ElhasnaouiMedina/Scanner-projet/Diaporama.pdf

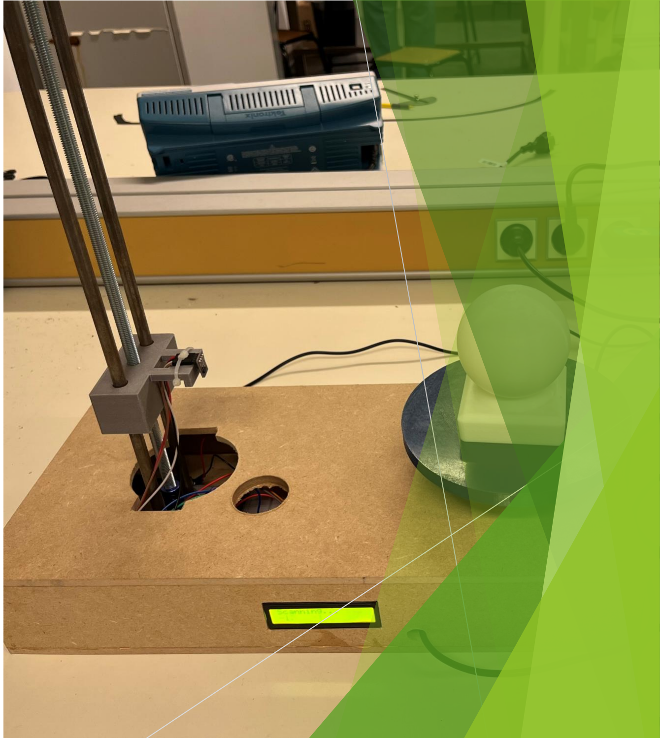
[picture p21: figure]

# Soutenance projet Arduino: Création d’un scanner 3D

MEDINA Anne-Marie

EL HASNAOUI Wiam

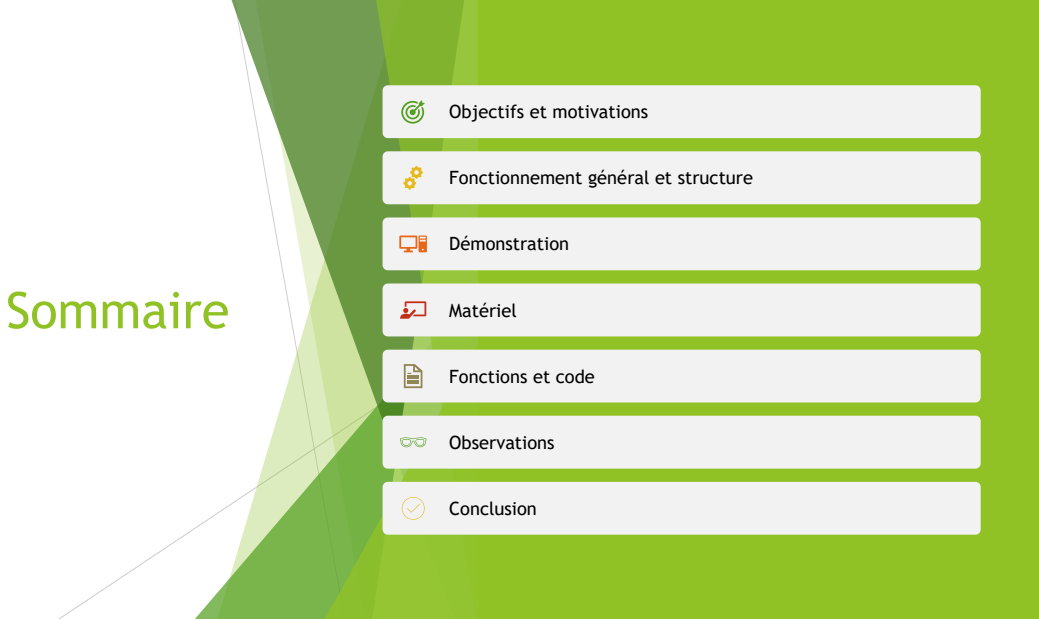
[picture p22: page 2]
Sommaire; Démonstration; Matériel; Observations; Conclusion

Objectifs et motivations

Fonctionnement général et structure

Fonctions et code

# Objectifs et motivations

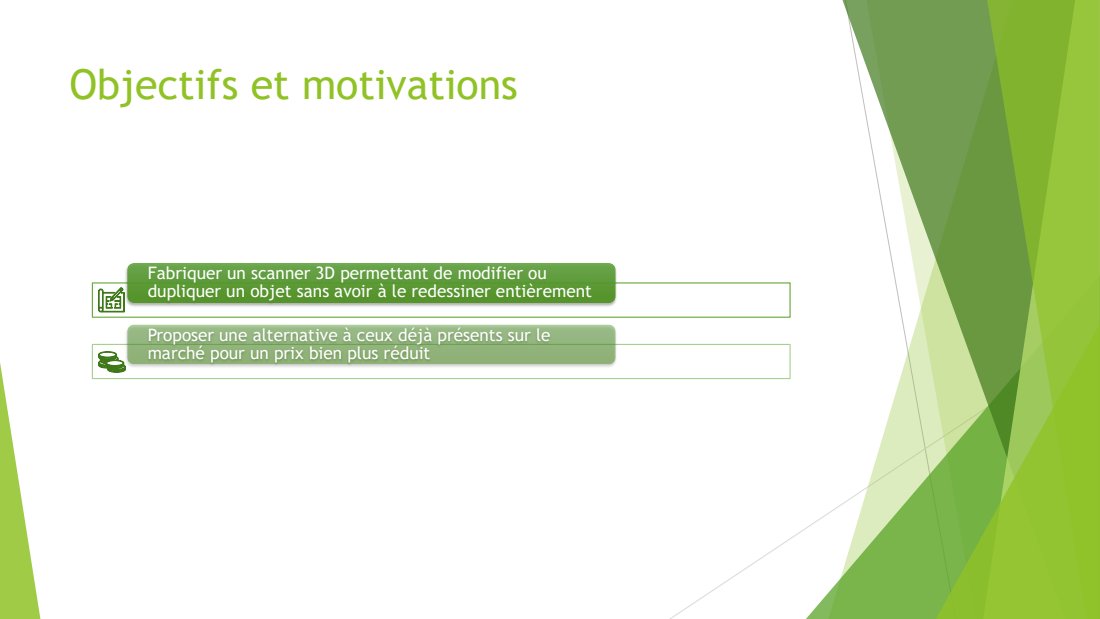
[picture p23: page 3]

Fabriquer un scanner 3D permettant de modifier ou
dupliquer un objet sans avoir à le redessiner entièrement

Proposer une alternative à ceux déjà présents sur le
marché pour un prix bien plus réduit

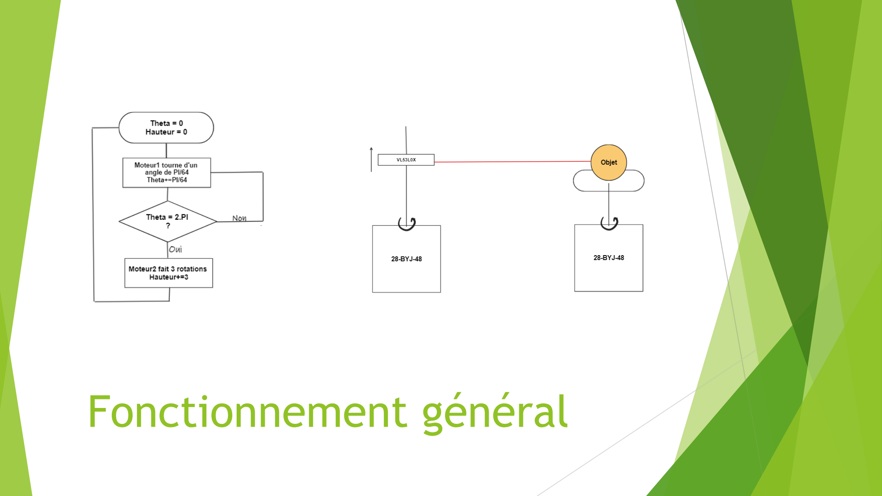
[picture p24: page 4]

# Fonctionnement général

# Structure

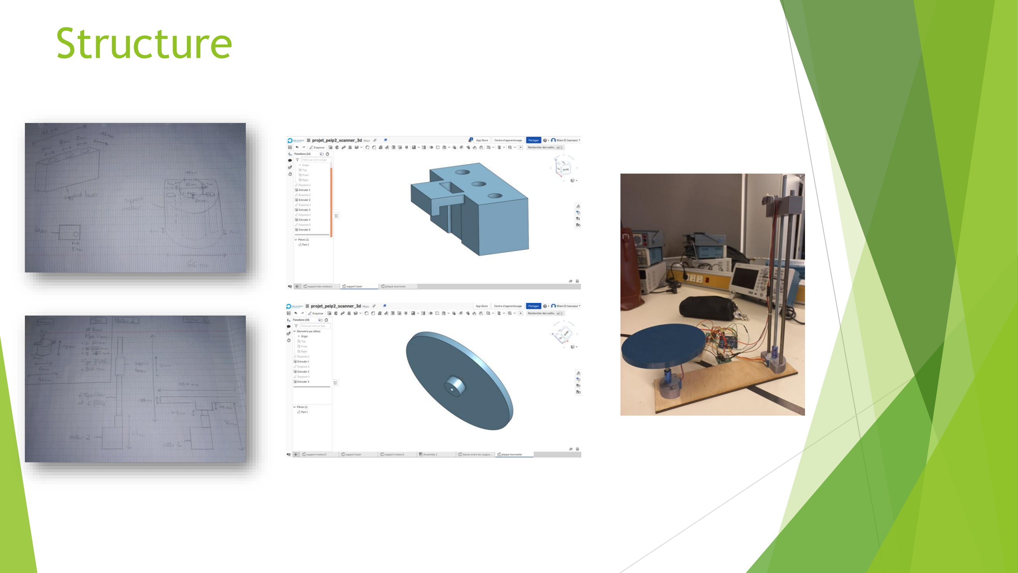
[picture p25: page 5]

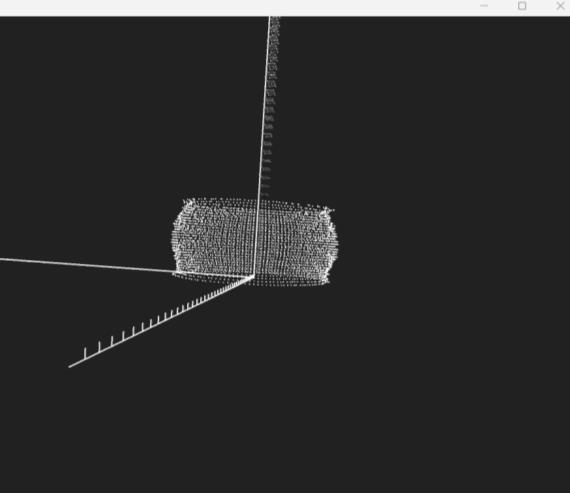
[picture p26: figure]
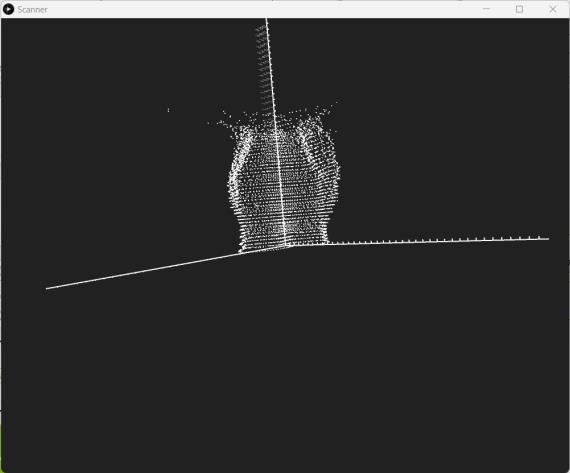
[picture p27: figure]
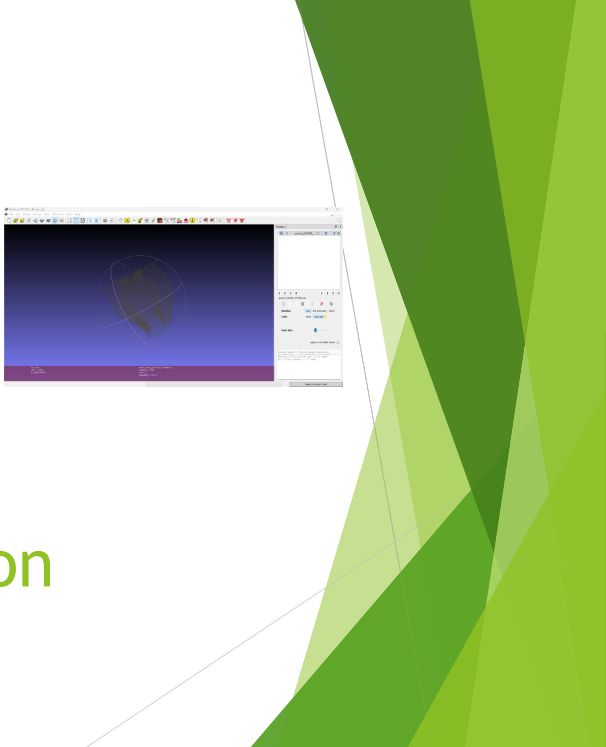
[picture p28: figure]

# Démonstration

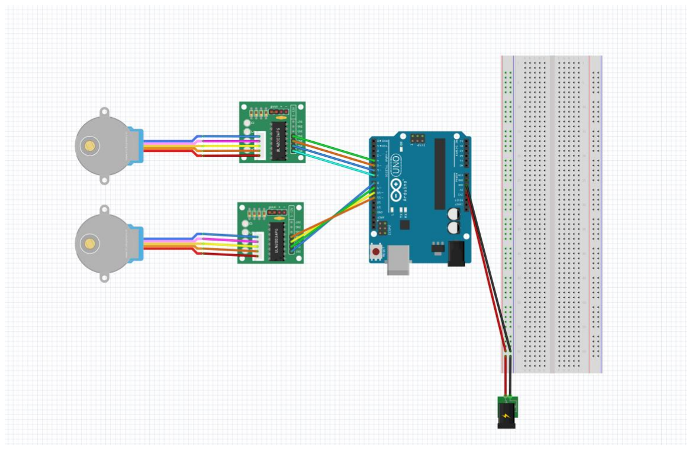
[picture p29: figure]

# Le moteur 28-BYJ-48

- Accompagné du
module UNL2003A
- Alimentée sous 5V

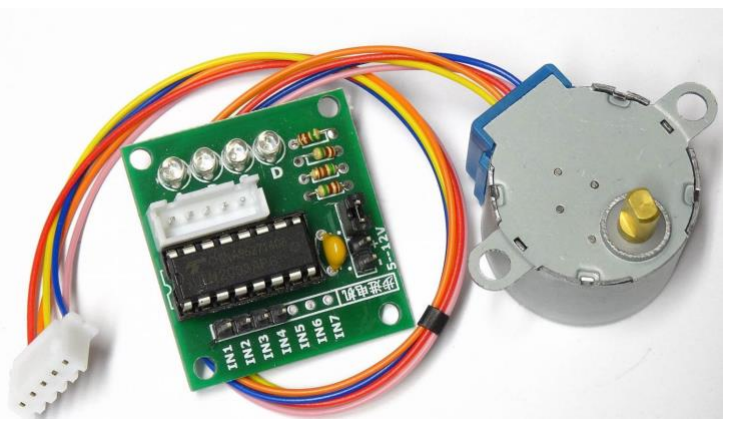
[picture p30: figure]

# Le capteur de distance VL53L0X

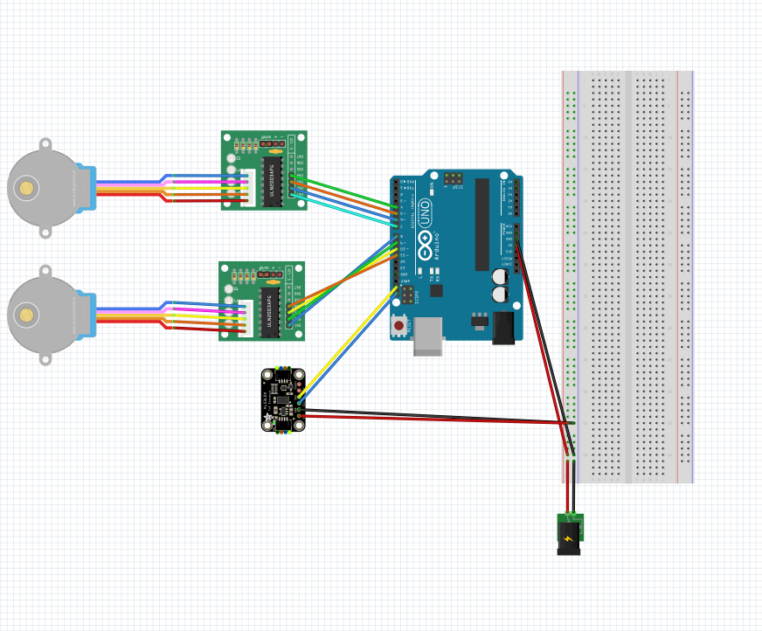
[picture p31: figure]

- Single high accuracy
- Communication via
moniteur série
- I2C

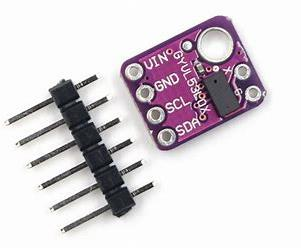
[picture p32: figure]

# Fonctions et code

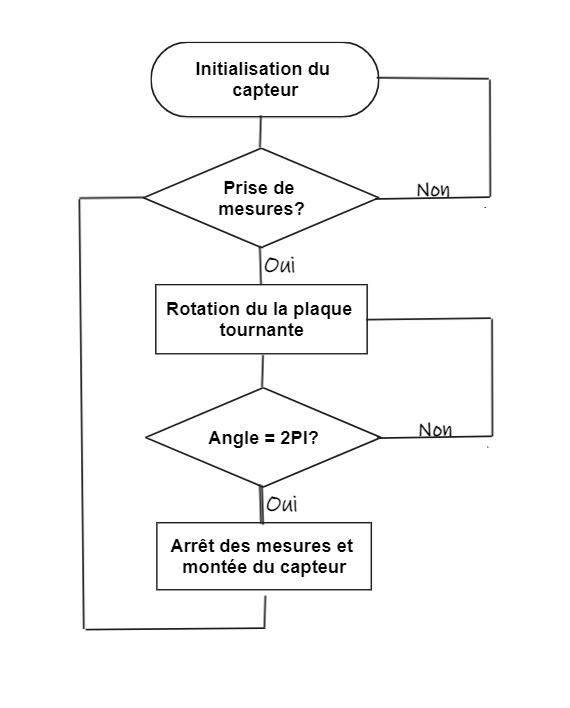
[picture p33: figure]

## Arduino et Processing: modélisation et nuage de

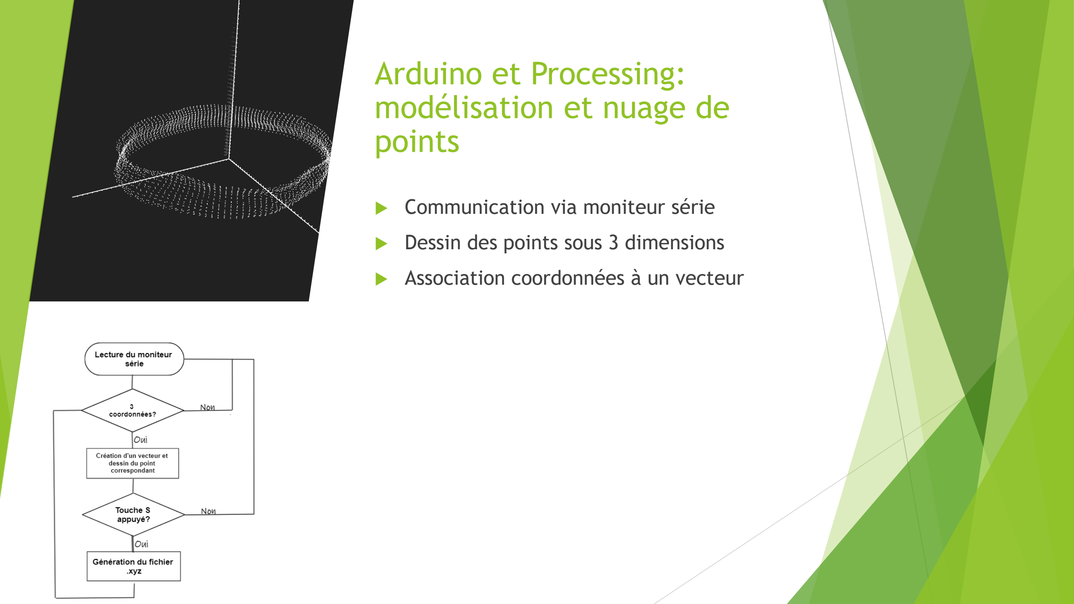
[picture p34: page 10]

## points

- Communication via moniteur série
- Dessin des points sous 3 dimensions
- Association coordonnées à un vecteur

# Faciliter l’utilisation du scanner

## - Deux boutons poussoirs

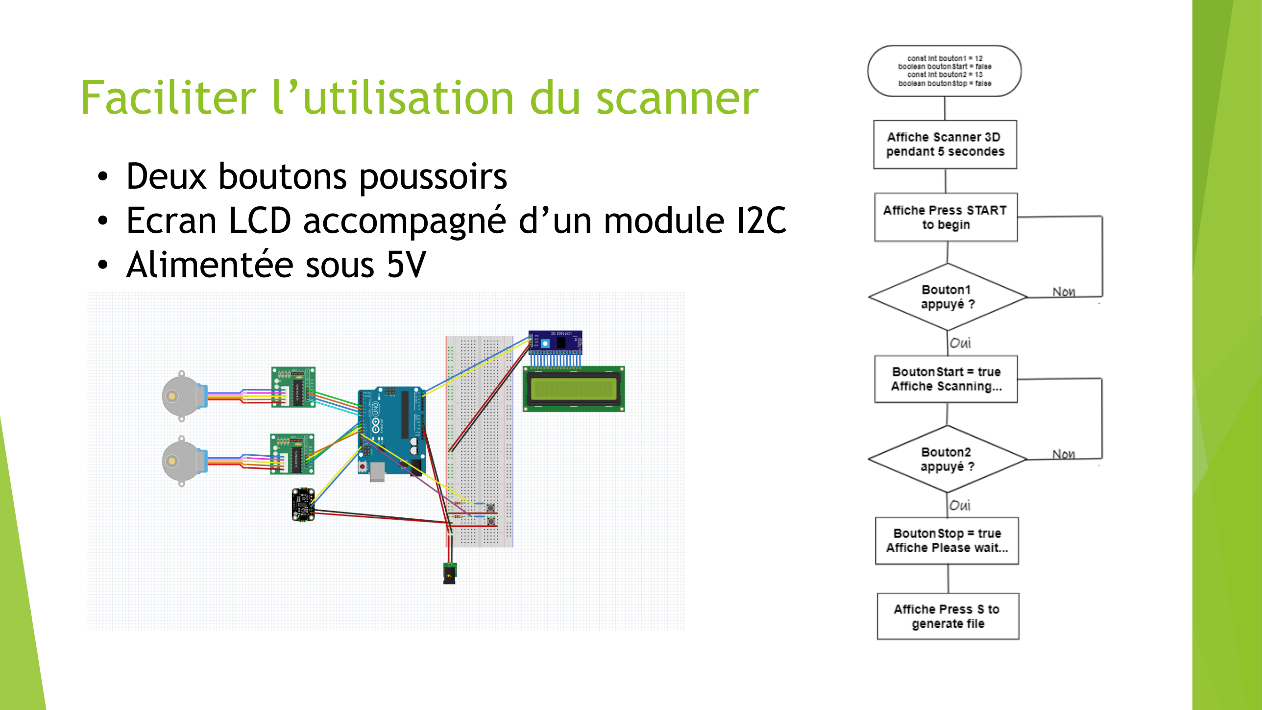
[picture p35: page 11]

## - Ecran LCD accompagné d’un module I2C - Alimentée sous 5V

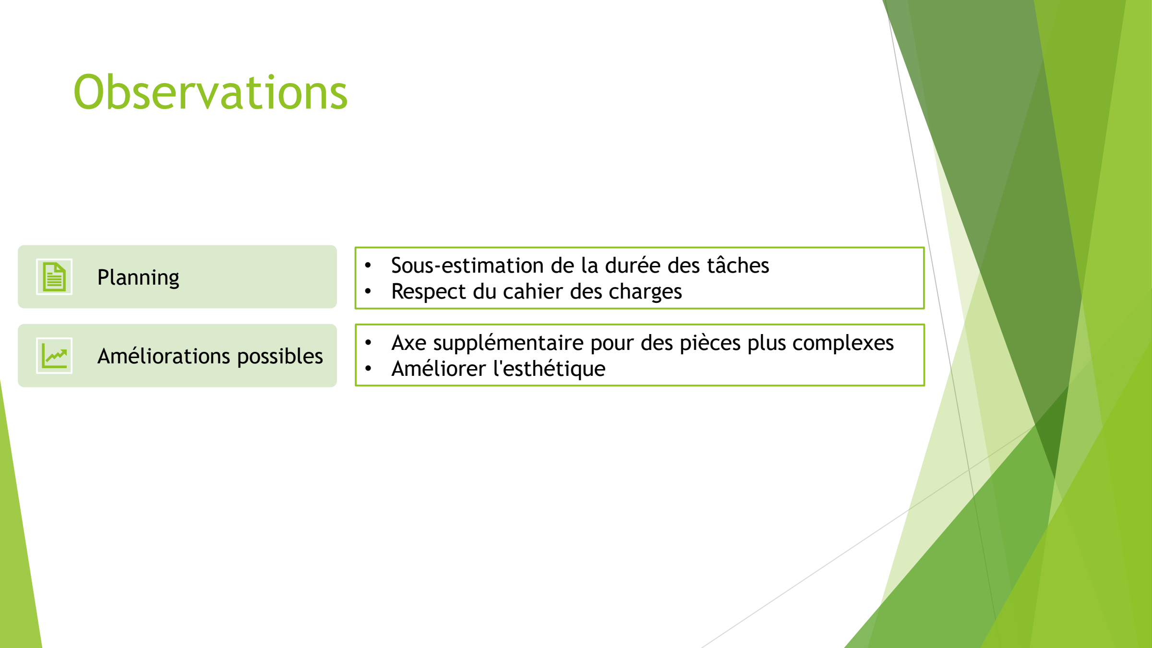
[picture p36: figure]
Observations; Planning; Améliorations possibles; • Respect du cahier des charges; • Améliorer l'esthétique

- Sous-estimation de la durée des tâches
- Axe supplémentaire pour des pièces plus complexes

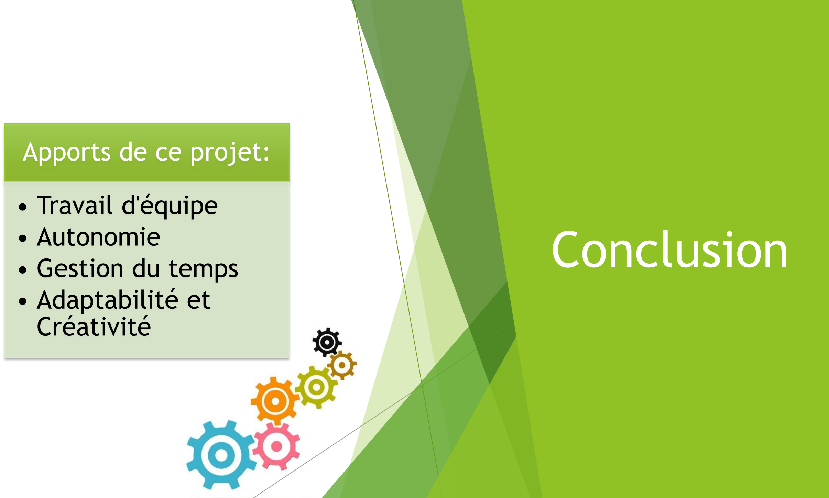
[picture p37: page 13]

## Apports de ce projet

:

## - Travail d'équipe • Autonomie • Gestion du temps • Adaptabilité et

## Créativité

# Conclusion
