ElhasnaouiMedina/Scanner-projet/Rapport séances/Planning_des_seances_Scanner.pdf

NUMERO
DE
SEANCE
SEANCE 1 | SEANCE 2 | SEANCE 3 | SEANCE 4

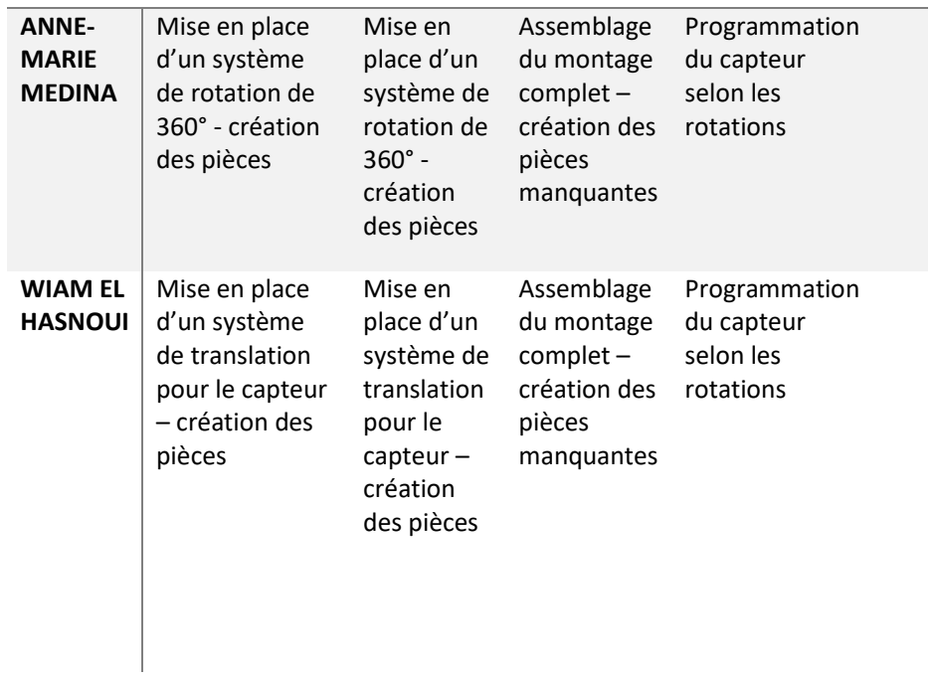
[picture p46: figure]
des pièces; pièces; création; manquantes; WIAM EL HASNOUI; Mise en place d’un système de translation pour le capteur – création des pièces; Assemblage du montage complet – création des pièces manquantes; Programmation du capteur selon les rotations

ANNE- | Mise en place | Mise en | Assemblage | Programmation
MARIE | d’un système | place d’un | du montage | du capteur
MEDINA | de rotation de | système de | complet – | selon les
| 360° - création | rotation de | création des | rotations

NUMERO DE
SEANCE
SEANCE 5 | SEANCE 6 | SEANCE 7 | SEANCE 8

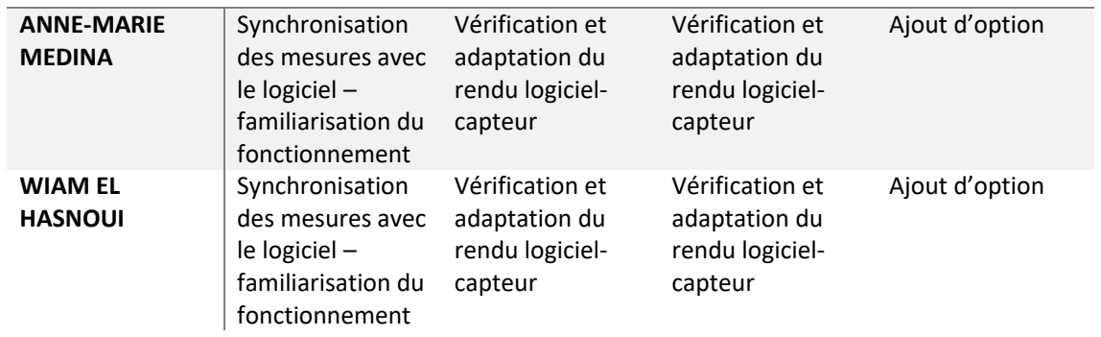
[picture p47: figure]
familiarisation du; capteur; fonctionnement; WIAM EL HASNOUI; Synchronisation des mesures avec le logiciel – familiarisation du fonctionnement; Vérification et adaptation du rendu logiciel- capteur; Ajout d’option

ANNE-MARIE | Synchronisation | Vérification et | Vérification et | Ajout d’option
MEDINA | des mesures avec | adaptation du | adaptation du
| le logiciel – | rendu logiciel- | rendu logiciel-
