ElhasnaouiMedina/Scanner-projet/Rapport séances/Compte-rendus/Séance 4/Compte-rendu_4_MEDINA.pdf

### Compte-rendu séance 4

### Anne-Marie MEDINA

Lors de cette séance, j’ai d’abord ajouté le code du premier moteur à mon code existant. Cela m’a permis d’obtenir la hauteur z (en fonction de la rotation du moteur) en plus des mesures du capteur. On adaptera les coordonnées selon la hauteur maximum dès qu’on a le montage complet.

On voit donc sur les photos et captures d’écran ci-dessous :

- le montage du capteur de distance et d’un moteur pas à pas
- les mesures r (la distance) et z dans le moniteur série telles que une ligne se présente avec ‘x z’ .
- puis les mesures sur Processing (en haut à gauche de la fenêtre). Sur la photo, afin de mieux observer les points les coordonnées sont ajoutées telles que x=r, y=z, z=50. On a la hauteur qui augmente selon la rotation du moteur

Vous trouverez sur Github les codes Arduino et Processing.

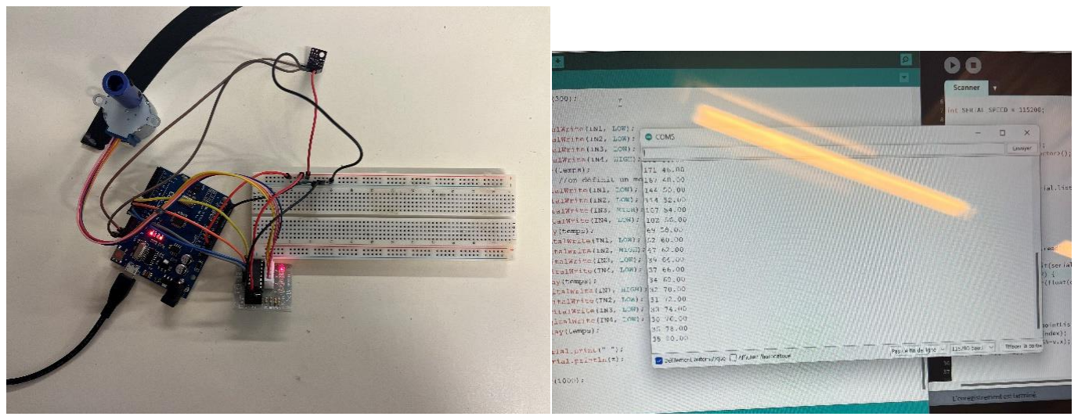
[picture p55: figure]
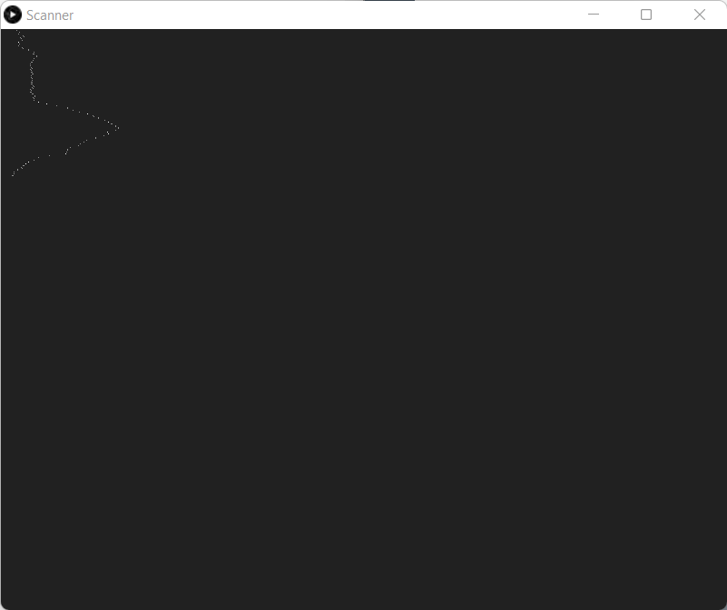
[picture p56: figure]

J’ai ensuite rajouté des méthodes sur Processing permettant de supprimer tous les points si souhaité et aussi de sauvegarder le nuage de points sous un fichier .xyz en appuyant sur la touche de clavier

‘s’. Ci-dessous le fichier xyz des mesures test et le fichier importé sous Meshlab. Maintenant y est une constante (50) et ce sont x (la distance) et z (la hauteur) qui varient.

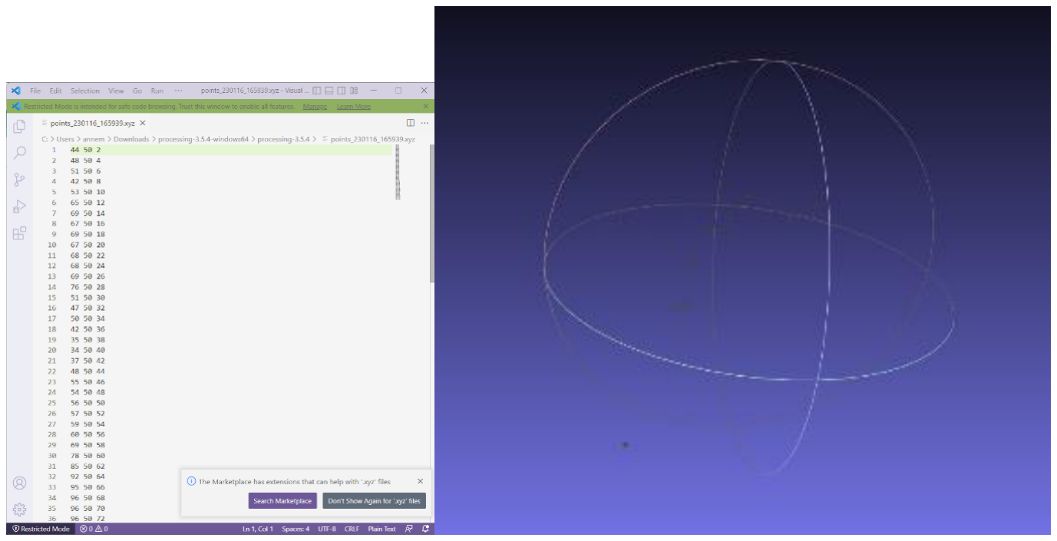
[picture p57: figure]

A la prochaine séance il faudra modifier x et ajouter y selon la distance et la rotation du deuxième moteur.
