ElhasnaouiMedina/Scanner-projet/Rapport séances/Compte-rendus/Séance 1/scan_distance.ino

#include "Adafruit_VL53L0X.h"

Adafruit_VL53L0X lox = Adafruit_VL53L0X();

void setup() {
  Serial.begin(9600);

  // wait until serial port opens for native USB devices
  while (! Serial) {
    delay(1);
  }
 
  if (!lox.begin()) {
    Serial.println("Failed to boot VL53L0X");
    while(1);
  }
  
}

void loop(){
  int t1 = millis();
  VL53L0X_RangingMeasurementData_t measure;
   
  Serial.print("Reading a measurement... ");
  lox.rangingTest(&measure, true); // pass in 'true' to get debug data printout!

  if (measure.RangeStatus != 4) {  // phase failures have incorrect data
    Serial.print("Distance (mm): ");
    Serial.println(measure.RangeMilliMeter);}
  else {
   Serial.println(" out of range ");
  }
  int t2 = millis();
  Serial.print("Time (ms): ");
  Serial.println(t2-t1);
  delay(100);
}
