ElhasnaouiMedina/Scanner-projet/(commit log)

2022-12-10 Create Cahier des charges.md
2022-12-10 Rename Cahier des charges.md to fichier essai.md
